nachtluce/3710-Project/Final Handin/Documentation/Implementation Documents/CPU Design.xls

Modules: | ALU |  |  |  |  |  | Mux(ALU Input) |  |  |  |  |  | VGA Start Address Register
ALU | Input |  |  | Output |  |  | Input |  |  | Output |  |  | Input |  |  | Output
Registers | Out(ALU Input) | >> | A | S | >> | In(Registers), In(ProgramCounter) | CPU | >> | InA | Out | >> | A(ALU) | Clock | >> | Clock | Out | >> | VGA
MemoryController | B(Registers) | >> | B | CLFZN | >> | In(PSR Register) | A(Registers) | >> | InB |  |  |  | CPU | >> | Reset
Mux | CPU | >> | OpCode |  |  |  | DataOut | >> | InC |  |  |  | CPU | >> | WriteEnable
CPUController | CPU | >> | OpExt |  |  |  | PC-Out | >> | InD |  |  |  | S | >> | In
PSR | PSR[4] | >> | Carry |  |  |  | CPU | >> | Select
ProgramCounter |  |  |  |  |  |  |  |  |  |  |  |  | VGA Row Length Register
InstructionRegister | Registers |  |  |  |  |  | Mux(MEM Addr) |  |  |  |  |  | Input |  |  | Output
 | Input |  |  | Output |  |  | Input |  |  | Output |  |  | Clock | >> | Clock | Out | >> | VGA
 | Clock | >> | Clock | A | >> | InA(ALU Input) | B(Registers) | >> | InA | Out | >> | Addr(MemoryController) | CPU | >> | Reset
 | Reset | >> | Reset | B | >> | A(ALU), InA(MEM Input) | PC | >> | InB |  |  |  | CPU | >> | WriteEnable
 | CPU | >> | WriteEnable |  |  |  | XX | >> | InC |  |  |  | S | >> | In
 | CPU | >> | SelectIn |  |  |  | XX | >> | InD
 | CPU | >> | SelectA |  |  |  | CPU | >> | Select
 | CPU | >> | SelectB
 | S(ALU) | >> | In |  |  |  | MemoryController
 |  |  |  |  |  |  | Input |  |  | Output
 | CPU Controller |  |  |  |  |  | Clock | >> | Clock | DataOut | >> | In(IR), InC(ALU Input)
 | Input |  |  | Output |  |  | CPU | >> | RW
 | Clock | >> | Clock | OpCode | >> | OpCode(ALU) | Out(MEM) | >> | Addr
 | Reset | >> | Reset | OpExt | >> | OpExt(ALU) | S(ALU) | >> | DataIn
 | INS | >> | INS | RegWrite | >> | WriteEnable(Registers)
 | PSR | >> | PSR | RegIn | >> | SelectIn(Registers) | Program Counter
 | GamePad | >> | GamePad | RegA | >> | SelectA(Registers) | Input |  |  | Output
 | SerialRead | >> | SerialControl | RegB | >> | SelectB(Registers) | Clock | >> | Clock | PC | >> | InB(MEM)
 | SerialValid | >> | SerialControl | Immediate | >> | InA(ALU Input) | CPU | >> | Reset
 |  |  |  | SelALU | >> | Select(ALU Input) | CPU | >> | WriteEnable
 |  |  |  | SelMEM | >> | Select(MEM Addr) | CPU | >> | Increment
 |  |  |  | MemRW | >> | RW(MemoryController) | S(ALU) | >> | In
 |  |  |  | PCWrite | >> | WriteEnable(Program Counter) | Immediate | >> | ImmIn
 |  |  |  | PCIncrement | >> | Increment(Program Counter)
 |  |  |  | PCReset | >> | Reset(Program Counter) | Instruction Register
 |  |  |  | IRReset | >> | Reset(Instruction Register) | Input |  |  | Output
 |  |  |  | IRWrite | >> | WriteEnable(Instruction Register) | Clock | >> | Clock | INS | >> | INS(CPU)
 |  |  |  | PSRReset | >> | Reset(Processor Status Register) | CPU | >> | Reset
 |  |  |  | PSREnable | >> | Enable(PSR) | CPU | >> | WriteEnable
 |  |  |  | VGAS_E | >> | Enable(VGAS-Reg) | DataOut | >> | In
 |  |  |  | VGAS_R | >> | Reset(VGAS-Reg
 |  |  |  | VGAR_E | >> | Enable(VGAR-Reg) | Processor Status Register
 |  |  |  | VGAR_R | >> | Reset(VGAR-Reg) | Input |  |  | Output
 |  |  |  | SerialWrite | >> | SerialControl | Clock | >> | Clock | PSR | >> | PSR(CPU), Carry(ALU)
 |  |  |  |  |  |  | CPU | >> | Reset
 |  |  |  |  |  |  | CLFZN(ALU) | >> | In
 |  |  |  |  |  |  | CPU | >> | Enable
