nachtluce/3710-Project/Final Handin/Project Code/Modules/VGA Controller/vgaBitGen.v

`timescale 1ns / 1ps
//////////////////////////////////////////////////////////////////////////////////
// Company: 
// Engineer: 
// 
// Create Date:    23:13:00 11/05/2011 
// Design Name: 
// Module Name:    vgaBitGen 
// Project Name: 
// Target Devices: 
// Tool versions: 
// Description: 
//
// Dependencies: 
//
// Revision: 
// Revision 0.01 - File Created
// Additional Comments: 
//
//////////////////////////////////////////////////////////////////////////////////
module vgaBitGen(
    input [8:0] picNum,
    input [4:0] xSubCount,
    input [4:0] ySubCount,
    input clk,
	 input act,
    output reg R,
    output reg B,
    output reg G
    );
	//memory
	
//ok this starts are the picNum we have 16 columns per superpixel
// and those 16 columns are within 6 addresses
//we start at 0x00 for our picture values
//pic1 is 0x00 to 0x5F
//pic2 is 0x60 to 0xBF
//pic3 is 0xC0 to 0x11F
//pic4 is 0x120 to 0x17F
//...
	reg[3:0] xWord;
	reg[10:0] yWord;
	wire [8:0] MemData;
	reg [11:0] fetchAddress;//this is the location to fetch in vga memory

	VGA_memory mem(~clk, 1'b0, fetchAddress, 9'b0_0000_0000, MemData);
	//on the posEdge of the clock what ever is on the fetch address, the memory on that location the memory will return on MemData or the value
	//of memData will be valid at the same clock
	
	
	

//always @(*)
//begin
//	if(xSubCount < 5 || xSubCount == 31)//first 6 pixels
//		 xWord = 0;
//	else if(xSubCount > 4 && xSubCount < 11)//6 to 12
//		 xWord = 1;
//	else if(xSubCount > 10 && xSubCount < 17)//12 to 18
//		 xWord = 2;
//	else if(xSubCount > 16 && xSubCount < 23)//18 to 24
//		 xWord = 3;//this section might still be off
//	else if(xSubCount > 22 && xSubCount < 29)//24 to 30
//		 xWord = 4;
//	else if(xSubCount > 28  && xSubCount < 31)//30 to 32
//		 xWord = 5;
//end
always @(*)
begin
	if(xSubCount < 6 || xSubCount == 31)//first 6 pixels
		 xWord = 0;
	else if(xSubCount > 5 && xSubCount < 12)//6 to 12
		 xWord = 1;
	else if(xSubCount > 11 && xSubCount < 18)//12 to 18
		 xWord = 2;
	else if(xSubCount > 12 && xSubCount < 24)//18 to 24
		 xWord = 3;//this section might still be off
	else if(xSubCount > 23 && xSubCount < 30)//24 to 30
		 xWord = 4;
	else if(xSubCount > 29  && xSubCount < 32)//30 to 32
		 xWord = 5;
end


//always @(*)
//	begin
//			if(ySubCount < 2)//row 0 of 16
//				 fetchAddress = xWord + (95 * picNum);
//			 else if(ySubCount > 1 && ySubCount < 4) //row 1
//				 fetchAddress = xWord + 6+ (95 * picNum);//
//			 else if(ySubCount > 3 && ySubCount < 6) //row 2
//				 fetchAddress = xWord + 12+ (95 * picNum);//
//			 else if(ySubCount > 5 && ySubCount < 8) //row 3
//				 fetchAddress = xWord + 18+ (95 * picNum);//
//			 else if(ySubCount > 7 && ySubCount < 10) //row 4
//				 fetchAddress = xWord + 24+ (95 * picNum);//
//			 else if(ySubCount > 9 && ySubCount < 12) //row 5
//				 fetchAddress = xWord + 30+ (95 * picNum);//
//			 else if(ySubCount > 11 && ySubCount < 14) //row 6
//				 fetchAddress = xWord + 36+ (95 * picNum);//
//			 else if(ySubCount > 13 && ySubCount < 16) //row 7
//				 fetchAddress = xWord + 42+ (95 * picNum);//
//			 else if(ySubCount > 15 && ySubCount < 18) //row 8
//				 fetchAddress = xWord + 48+ (95 * picNum);//
//			 else if(ySubCount > 17 && ySubCount < 20) //row 9
//				 fetchAddress = xWord + 54+ (95 * picNum);//
//			 else if(ySubCount > 19 && ySubCount < 22) //row 10
//				 fetchAddress = xWord + 60+ (95 * picNum);//
//			 else if(ySubCount > 21 && ySubCount < 24) //row 11
//				 fetchAddress = xWord + 66+ (95 * picNum);//
//			 else if(ySubCount > 23 && ySubCount < 26) //row 12
//				 fetchAddress = xWord + 72+ (95 * picNum);//
//			 else if(ySubCount > 25 && ySubCount < 28) //row 13
//				 fetchAddress = xWord + 78+ (95 * picNum);//
//			 else if(ySubCount > 27 && ySubCount < 30) //row 14
//				 fetchAddress = xWord + 84+ (95 * picNum);//
//			 else if(ySubCount > 29 && ySubCount < 32) //row 14
//				 fetchAddress = xWord + 90+ (95 * picNum);//
//			 else
//				 fetchAddress = 10'b0000_0000_00;
//			
//		 //end
////	
////		if(ySubCount < 2)
////			yWord = 0;
////		else if(ySubCount > 1 && ySubCount < 4)
////			yWord = 1;
////		else if(ySubCount > 3 && ySubCount < 6)
////			yWord = 2;
////		else if(ySubCount > 5 && ySubCount < 8)
////			yWord = 3;
////		else if(ySubCount > 7 && ySubCount < 10)
////			yWord = 4;
////		else if(ySubCount > 9 && ySubCount < 12)
////			yWord = 5;
////		else if(ySubCount > 11 && ySubCount < 14)
////			yWord = 6;
////		else if(ySubCount > 13 && ySubCount < 16)
////			yWord = 7;
////		else if(ySubCount > 15 && ySubCount < 18)
////			yWord = 8;
////		else if(ySubCount > 17 && ySubCount < 20)
////			yWord = 9;
////		else if(ySubCount > 19 && ySubCount < 22)
////			yWord = 10;
////		else if(ySubCount > 21 && ySubCount < 24)
////			yWord = 11;
////		else if(ySubCount > 23 && ySubCount < 26)
////			yWord = 12;
////		else if(ySubCount > 25 && ySubCount < 28)
////			yWord = 13;
////		else if(ySubCount > 27 && ySubCount < 30)
////			yWord = 14;
////		else if(ySubCount > 29 && ySubCount < 32)
////			yWord = 15;
////		else
////			yWord = 0;
//		
//	
//	end

//always @(*)
//begin												
//	fetchAddress = ((picNum * 95) +(yWord * 6)+(xWord ));
//end
//
always @(*)//this use to be posegde clk
begin
		//we need a multiplier to advance the image address based on 
		//fetchAddress = (picNum * 95) +(xWord + yWord);
		//example 0 * 95 = 0 + (0 +0); = 0
		//example 2  1 * 95 +
		 if(picNum == 0)//Dude Right
		 begin
		
			
			 if(ySubCount < 2)//row 0 of 16
				 fetchAddress = xWord + 0;
			 else if(ySubCount > 1 && ySubCount < 4) //row 1
				 fetchAddress = xWord + 6;//
			 else if(ySubCount > 3 && ySubCount < 6) //row 2
				 fetchAddress = xWord + 12;//
			 else if(ySubCount > 5 && ySubCount < 8) //row 3
				 fetchAddress = xWord + 18;//
			 else if(ySubCount > 7 && ySubCount < 10) //row 4
				 fetchAddress = xWord + 24;//
			 else if(ySubCount > 9 && ySubCount < 12) //row 5
				 fetchAddress = xWord + 30;//
			 else if(ySubCount > 11 && ySubCount < 14) //row 6
				 fetchAddress = xWord + 36;//
			 else if(ySubCount > 13 && ySubCount < 16) //row 7
				 fetchAddress = xWord + 42;//
			 else if(ySubCount > 15 && ySubCount < 18) //row 8
				 fetchAddress = xWord + 48;//
			 else if(ySubCount > 17 && ySubCount < 20) //row 9
				 fetchAddress = xWord + 54;//
			 else if(ySubCount > 19 && ySubCount < 22) //row 10
				 fetchAddress = xWord + 60;//
			 else if(ySubCount > 21 && ySubCount < 24) //row 11
				 fetchAddress = xWord + 66;//
			 else if(ySubCount > 23 && ySubCount < 26) //row 12
				 fetchAddress = xWord + 72;//
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
//R = MemData[8];
//			G = MemData[7];
//			B = MemData[6];

		end
		else if(xSubCount < 18 && xSubCount > 15 && act)
		begin
	
	//		{R,B,G} = 3'b110;//Set Red for all of the pixels
			{R,B,G} = MemData[2:0];//set the RGB		pixel 9
//R = MemData[8];
//			G = MemData[7];
//			B = MemData[6];

		end
		else if(xSubCount < 20 && xSubCount > 17 && act)
		begin
		
//			{R,B,G} = 3'b110;//Set Red for all of the pixels
			{R,B,G} = MemData[8:6];//set the RGB		pixel 10
//R = MemData[8];
//			G = MemData[7];
//			B = MemData[6];

		end
		else if(xSubCount < 22 && xSubCount > 19 && act)
		begin

//			{R,B,G} = 3'b110;//Set Red for all of the pixels
			{R,B,G} = MemData[5:3];//set the RGB		pixel 11
		end
		else if(xSubCount < 24 && xSubCount > 21 && act)
		begin
		
	//		{R,B,G} = 3'b110;//Set Red for all of the pixels
			{R,B,G} = MemData[2:0];//set the RGB		pixel 12
		end
		else if(xSubCount < 26 && xSubCount > 23 && act)
		begin

//			{R,B,G} = 3'b110;//Set Red for all of the pixels		
		{R,B,G} = MemData[8:6];//set the RGB		pixel 13
		end
		else if(xSubCount < 28 && xSubCount > 25 && act)
		begin

//			{R,B,G} = 3'b110;//Set Red for all of the pixels	
	{R,B,G} = MemData[5:3];//set the RGB		pixel 14
		end
		else if(xSubCount < 30 && xSubCount > 27 && act)
		begin

//			{R,B,G} = 3'b110;//Set Red for all of the pixels	
	{R,B,G} = MemData[2:0];//set the RGB		pixel 15
		end
		else if(xSubCount < 32 && xSubCount > 29 && act)
		begin
	
	//		{R,B,G} = 3'b110;//Set Red for all of the pixels
			{R,B,G} = MemData[8:6];//set the RGB		pixel 16
		end//000000000, we want the first 2 locations set
		//100001010;0x10A
		else
			{R,B,G} = 0;
		
		
end


endmodule
