nachtluce/3710-Project/Final Handin/Project Code/Modules/VGA Controller/VGASuperPixConverter.v

`timescale 1ns / 1ps
//////////////////////////////////////////////////////////////////////////////////
// Company: 
// Engineer: 
// 
// Create Date:    12:19:10 11/01/2011 
// Design Name: 
// Module Name:    VGASuperPixConverter 
// Project Name: 
// Target Devices: 
// Tool versions: 
// Description: This module is to convert the col and row into a 
//
// Dependencies: 
//
// Revision: 
// Revision 0.01 - File Created
// Additional Comments: 
//
//////////////////////////////////////////////////////////////////////////////////
module VGASuperPixConverter(
    input [9:0] col,
    input [8:0] row,
    output reg [4:0] xSupPix,
    output reg [3:0] ySupPix,
	 output reg [4:0] xSubCount,
	 output reg [4:0] ySubCount	 
    );
always @(*)
begin 

		xSupPix = 0;
		 ySupPix = 0;
	if(col < 32)// && act)
	begin	
		xSupPix = 0; 
		 xSubCount = col;
	end
	else if( col >31 && col < 64)// && act)//pixels 32 - 63
	begin
		 xSupPix = 1;
		 xSubCount = col - 32;
	end
	else if( col >63 && col < 96)//&& act)//pixels 32 - 63
	begin
		 xSupPix = 2;
		 xSubCount = col - 64;
	end
	else if( col >95 && col < 128)// && act)//pixels 32 - 63
	begin
		 xSupPix = 3;
		 xSubCount = col - 96;
	end
	else if( col >127 && col < 160)// && act)//pixels 32 - 63
	begin
		 xSupPix = 4;
		 xSubCount = col - 128;
	end
	else if( col >159 && col < 192)// && act)//pixels 32 - 63
	begin
		 xSupPix = 5;
		 xSubCount = col - 160;
	end
	else if( col >191 && col < 224)// && act)//pixels 32 - 63
	begin	
		 xSupPix = 6;
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
	end
	else if( row > 415 && row < 448)// && act)
	begin
		 ySupPix = 13;
		 ySubCount = row - 416;
	end
	else if( row > 447 && row < 480)// && act)
	begin
		 ySupPix = 14;
		 ySubCount = row - 448;
	end
	else
	begin
		 ySupPix = 5'bxxxxx;
		 ySubCount = 5'bxxxxx;
	end
	 
end
endmodule
