nachtluce/3710-Project/Final Handin/Project Code/Modules/CPU/Processor_Status_Register.v

`timescale 1ns / 1ps
//////////////////////////////////////////////////////////////////////////////////
// Company: 
// Engineer:	Levi Balling, Robert Christensen, James Lewis
// 
// Create Date:    15:07:38 09/19/2011 
// Design Name: 
// Module Name:    Processor_Status_Register 
// Project Name: 
// Target Devices: 
// Tool versions: 
// Description: 
//
// Dependencies: 
//
// Revision: 
// Revision 0.01 - File Created
// Additional Comments: 
//
//////////////////////////////////////////////////////////////////////////////////
module Processor_Status_Register(
	 input clock,
	 input reset,
	 input enable,
    input [4:0] CZLFM_in,
    output reg[4:0] CZLFN_out 
    );

always@(posedge clock, negedge reset)
begin
	if (~reset)
		CZLFN_out <= 0;
	else	
	if (enable)
		CZLFN_out <= CZLFM_in;
		
end

endmodule
