nachtluce/3710-Project/Final Handin/Project Code/Test Benches/ALU_simulation/ALUmod_synthesis.v

////////////////////////////////////////////////////////////////////////////////
// Copyright (c) 1995-2010 Xilinx, Inc.  All rights reserved.
////////////////////////////////////////////////////////////////////////////////
//   ____  ____
//  /   /\/   /
// /___/  \  /    Vendor: Xilinx
// \   \   \/     Version: M.53d
//  \   \         Application: netgen
//  /   /         Filename: ALUmod_synthesis.v
// /___/   /\     Timestamp: Thu Sep 22 15:55:03 2011
// \   \  /  \ 
//  \___\/\___\
//             
// Command	: -intstyle ise -insert_glbl true -w -dir netgen/synthesis -ofmt verilog -sim ALUmod.ngc ALUmod_synthesis.v 
// Device	: xc3s500e-5-vq100
// Input file	: ALUmod.ngc
// Output file	: C:\Users\robertc\Documents\school\CS3710\ALU\netgen\synthesis\ALUmod_synthesis.v
// # of Modules	: 1
// Design Name	: ALUmod
// Xilinx        : C:\Xilinx\12.1\ISE_DS\ISE
//             
// Purpose:    
//     This verilog netlist is a verification model and uses simulation 
//     primitives which may not represent the true implementation of the 
//     device, however the netlist is functionally correct and should not 
//     be modified. This file cannot be synthesized and should only be used 
//     with supported simulation tools.
//             
// Reference:  
//     Command Line Tools User Guide, Chapter 23 and Synthesis and Simulation Design Guide, Chapter 6
//             
////////////////////////////////////////////////////////////////////////////////

`timescale 1 ns/1 ps

module ALUmodSynth (
  carry, S, CLFZN, opext, A, B, opcode
);
  input carry;
  output [15 : 0] S;
  output [4 : 0] CLFZN;
  input [3 : 0] opext;
  input [15 : 0] A;
  input [15 : 0] B;
  input [3 : 0] opcode;
  wire A_0_IBUF_32;
  wire A_10_IBUF_33;
  wire A_11_IBUF_34;
  wire A_12_IBUF_35;
  wire A_13_IBUF_36;
  wire A_14_IBUF_37;
  wire A_15_IBUF_38;
  wire A_1_IBUF_39;
  wire A_2_IBUF_40;
  wire A_3_IBUF_41;
  wire A_4_IBUF_42;
  wire A_5_IBUF_43;
  wire A_6_IBUF_44;
  wire A_7_IBUF_45;
  wire A_8_IBUF_46;
  wire A_9_IBUF_47;
  wire B_0_IBUF_64;
  wire B_10_IBUF_65;
  wire B_11_IBUF_66;
  wire B_12_IBUF_67;
  wire B_13_IBUF_68;
  wire B_14_IBUF_69;
  wire B_15_IBUF_70;
  wire B_1_IBUF_71;
  wire B_2_IBUF_72;
  wire B_3_IBUF_73;
  wire B_4_IBUF_74;
  wire B_5_IBUF_75;
  wire B_6_IBUF_76;
  wire B_7_IBUF_77;
  wire B_8_IBUF_78;
  wire B_9_IBUF_79;
  wire CLFZN_0_OBUF_85;
  wire CLFZN_0_mux000018_86;
  wire CLFZN_1_OBUF_87;
  wire CLFZN_2_OBUF_88;
  wire CLFZN_2_mux000112_89;
  wire CLFZN_2_mux0001124_90;
  wire CLFZN_2_mux0001153_91;
  wire CLFZN_2_mux0001172_92;
  wire CLFZN_2_mux000121_93;
  wire CLFZN_2_mux00015_94;
  wire CLFZN_2_mux000155_95;
  wire CLFZN_2_mux000170_96;
  wire CLFZN_3_OBUF_97;
  wire CLFZN_4_OBUF_98;
  wire CLFZN_4_cmp_eq0001;
  wire CLFZN_4_cmp_eq0002;
  wire CLFZN_4_cmp_eq00031;
  wire CLFZN_4_cmp_eq0004;
  wire CLFZN_4_cmp_eq0005;
  wire CLFZN_4_cmp_eq0008;
  wire CLFZN_4_cmp_eq0009;
  wire CLFZN_4_cmp_eq0010;
  wire CLFZN_4_cmp_eq0013;
  wire CLFZN_4_cmp_eq00131_108;
  wire CLFZN_4_cmp_eq0016;
  wire Madd_AUX_5_index0000;
  wire \Madd__AUX_9_cy<10>_rt_144 ;
  wire \Madd__AUX_9_cy<11>_rt_146 ;
  wire \Madd__AUX_9_cy<12>_rt_148 ;
  wire \Madd__AUX_9_cy<13>_rt_150 ;
  wire \Madd__AUX_9_cy<14>_rt_152 ;
  wire \Madd__AUX_9_cy<15>_rt_154 ;
  wire \Madd__AUX_9_cy<1>_rt_156 ;
  wire \Madd__AUX_9_cy<2>_rt_158 ;
  wire \Madd__AUX_9_cy<3>_rt_160 ;
  wire \Madd__AUX_9_cy<4>_rt_162 ;
  wire \Madd__AUX_9_cy<5>_rt_164 ;
  wire \Madd__AUX_9_cy<6>_rt_166 ;
  wire \Madd__AUX_9_cy<7>_rt_168 ;
  wire \Madd__AUX_9_cy<8>_rt_170 ;
  wire \Madd__AUX_9_cy<9>_rt_172 ;
  wire \Madd__AUX_9_xor<16>_rt_174 ;
  wire N0;
  wire N01;
  wire N1;
  wire N10;
  wire N11;
  wire N18;
  wire N2;
  wire N3;
  wire N36;
  wire N38;
  wire N39;
  wire N411;
  wire N42;
  wire N43;
  wire N44;
  wire N47;
  wire N5;
  wire N55;
  wire N57;
  wire N59;
  wire N61;
  wire N63;
  wire N65;
  wire N67;
  wire N69;
  wire N7;
  wire N71;
  wire N73;
  wire N75;
  wire N77;
  wire N8;
  wire N81;
  wire N89;
  wire N9;
  wire N91;
  wire N93;
  wire N94;
  wire \S<0>136_324 ;
  wire \S<0>17_325 ;
  wire \S<0>182_326 ;
  wire \S<0>217_327 ;
  wire \S<0>232_328 ;
  wire \S<0>258_329 ;
  wire \S<0>30_330 ;
  wire \S<0>4_331 ;
  wire \S<0>43_332 ;
  wire \S<0>67_333 ;
  wire \S<0>76_334 ;
  wire \S<0>89_335 ;
  wire \S<10>11 ;
  wire \S<10>1116_338 ;
  wire \S<10>144_339 ;
  wire \S<10>21_340 ;
  wire \S<10>4_341 ;
  wire \S<10>40_342 ;
  wire \S<10>49_343 ;
  wire \S<10>7_344 ;
  wire \S<11>11_346 ;
  wire \S<11>21_347 ;
  wire \S<11>4_348 ;
  wire \S<11>40_349 ;
  wire \S<11>49_350 ;
  wire \S<11>7_351 ;
  wire \S<12>11_353 ;
  wire \S<12>21_354 ;
  wire \S<12>4_355 ;
  wire \S<12>40_356 ;
  wire \S<12>49_357 ;
  wire \S<12>7_358 ;
  wire \S<13>11_360 ;
  wire \S<13>21_361 ;
  wire \S<13>4_362 ;
  wire \S<13>40_363 ;
  wire \S<13>49_364 ;
  wire \S<13>7_365 ;
  wire \S<14>13_367 ;
  wire \S<14>32_368 ;
  wire \S<14>53_369 ;
  wire \S<14>6_370 ;
  wire \S<15>110_372 ;
  wire \S<15>125_373 ;
  wire \S<15>45_374 ;
  wire \S<15>61_375 ;
  wire \S<15>79_376 ;
  wire \S<15>95_377 ;
  wire \S<1>11_379 ;
  wire \S<1>18_380 ;
  wire \S<1>22_381 ;
  wire \S<1>4_382 ;
  wire \S<1>45_383 ;
  wire \S<1>54_384 ;
  wire \S<2>11_386 ;
  wire \S<2>18_387 ;
  wire \S<2>22_388 ;
  wire \S<2>4_389 ;
  wire \S<2>45_390 ;
  wire \S<2>54_391 ;
  wire \S<3>11_393 ;
  wire \S<3>18_394 ;
  wire \S<3>22_395 ;
  wire \S<3>4_396 ;
  wire \S<3>45_397 ;
  wire \S<3>54_398 ;
  wire \S<4>11_400 ;
  wire \S<4>18_401 ;
  wire \S<4>22_402 ;
  wire \S<4>4_403 ;
  wire \S<4>45_404 ;
  wire \S<4>54_405 ;
  wire \S<5>11_407 ;
  wire \S<5>18_408 ;
  wire \S<5>4_409 ;
  wire \S<5>45_410 ;
  wire \S<5>54_411 ;
  wire \S<5>73 ;
  wire \S<6>11_414 ;
  wire \S<6>18_415 ;
  wire \S<6>4_416 ;
  wire \S<6>45_417 ;
  wire \S<6>54_418 ;
  wire \S<6>73 ;
  wire \S<7>11_421 ;
  wire \S<7>21_422 ;
  wire \S<7>40_423 ;
  wire \S<7>49_424 ;
  wire \S<7>61_425 ;
  wire \S<8>11_427 ;
  wire \S<8>21_428 ;
  wire \S<8>4_429 ;
  wire \S<8>40_430 ;
  wire \S<8>49_431 ;
  wire \S<8>7_432 ;
  wire \S<9>11_434 ;
  wire \S<9>21_435 ;
  wire \S<9>4_436 ;
  wire \S<9>40_437 ;
  wire \S<9>49_438 ;
  wire \S<9>7_439 ;
  wire S_0_OBUF_440;
  wire S_10_OBUF_441;
  wire S_11_OBUF_442;
  wire S_12_OBUF_443;
  wire S_13_OBUF_444;
  wire S_14_OBUF_445;
  wire S_15_OBUF_446;
  wire S_1_OBUF_447;
  wire S_2_OBUF_448;
  wire S_3_OBUF_449;
  wire S_4_OBUF_450;
  wire S_5_OBUF_451;
  wire S_6_OBUF_452;
  wire S_7_OBUF_453;
  wire S_8_OBUF_454;
  wire S_9_OBUF_455;
  wire carry_IBUF_490;
  wire opcode_0_IBUF_495;
  wire opcode_1_IBUF_496;
  wire opcode_2_IBUF_497;
  wire opcode_3_IBUF_498;
  wire opext_0_IBUF_503;
  wire opext_1_IBUF_504;
  wire opext_2_IBUF_505;
  wire opext_3_IBUF_506;
  wire [15 : 0] AUX_5_addsub0000;
  wire [14 : 0] Madd_AUX_5_addsub0000_cy;
  wire [15 : 0] Madd_AUX_5_addsub0000_lut;
  wire [15 : 0] Madd__AUX_9_cy;
  wire [0 : 0] Madd__AUX_9_lut;
  wire [7 : 0] Mcompar_CLFZN_cmp_eq0000_cy;
  wire [7 : 0] Mcompar_CLFZN_cmp_eq0000_lut;
  wire [15 : 0] Mcompar_CLFZN_cmp_gt0000_cy;
  wire [15 : 0] Mcompar_CLFZN_cmp_gt0000_lut;
  wire [15 : 0] Mcompar_CLFZN_cmp_gt0001_cy;
  wire [15 : 0] Mcompar_CLFZN_cmp_gt0001_lut;
  wire [14 : 0] Msub__old_S_10_cy;
  wire [15 : 0] Msub__old_S_10_lut;
  wire [16 : 0] _AUX_9;
  wire [15 : 0] _old_S_10;
  GND   XST_GND (
    .G(N0)
  );
  VCC   XST_VCC (
    .P(N1)
  );
  LUT2 #(
    .INIT ( 4'h6 ))
  \Madd_AUX_5_addsub0000_lut<0>  (
    .I0(A_0_IBUF_32),
    .I1(B_0_IBUF_64),
    .O(Madd_AUX_5_addsub0000_lut[0])
  );
  MUXCY   \Madd_AUX_5_addsub0000_cy<0>  (
    .CI(N0),
    .DI(A_0_IBUF_32),
    .S(Madd_AUX_5_addsub0000_lut[0]),
    .O(Madd_AUX_5_addsub0000_cy[0])
  );
  XORCY   \Madd_AUX_5_addsub0000_xor<0>  (
    .CI(N0),
    .LI(Madd_AUX_5_addsub0000_lut[0]),
    .O(AUX_5_addsub0000[0])
  );
  LUT2 #(
    .INIT ( 4'h6 ))
  \Madd_AUX_5_addsub0000_lut<1>  (
    .I0(A_1_IBUF_39),
    .I1(B_1_IBUF_71),
    .O(Madd_AUX_5_addsub0000_lut[1])
  );
  MUXCY   \Madd_AUX_5_addsub0000_cy<1>  (
    .CI(Madd_AUX_5_addsub0000_cy[0]),
    .DI(A_1_IBUF_39),
    .S(Madd_AUX_5_addsub0000_lut[1]),
    .O(Madd_AUX_5_addsub0000_cy[1])
  );
  XORCY   \Madd_AUX_5_addsub0000_xor<1>  (
    .CI(Madd_AUX_5_addsub0000_cy[0]),
    .LI(Madd_AUX_5_addsub0000_lut[1]),
    .O(AUX_5_addsub0000[1])
  );
  LUT2 #(
    .INIT ( 4'h6 ))
  \Madd_AUX_5_addsub0000_lut<2>  (
    .I0(A_2_IBUF_40),
    .I1(B_2_IBUF_72),
    .O(Madd_AUX_5_addsub0000_lut[2])
  );
  MUXCY   \Madd_AUX_5_addsub0000_cy<2>  (
    .CI(Madd_AUX_5_addsub0000_cy[1]),
    .DI(A_2_IBUF_40),
    .S(Madd_AUX_5_addsub0000_lut[2]),
    .O(Madd_AUX_5_addsub0000_cy[2])
  );
  XORCY   \Madd_AUX_5_addsub0000_xor<2>  (
    .CI(Madd_AUX_5_addsub0000_cy[1]),
    .LI(Madd_AUX_5_addsub0000_lut[2]),
    .O(AUX_5_addsub0000[2])
  );
  LUT2 #(
    .INIT ( 4'h6 ))
  \Madd_AUX_5_addsub0000_lut<3>  (
    .I0(A_3_IBUF_41),
    .I1(B_3_IBUF_73),
    .O(Madd_AUX_5_addsub0000_lut[3])
  );
  MUXCY   \Madd_AUX_5_addsub0000_cy<3>  (
    .CI(Madd_AUX_5_addsub0000_cy[2]),
    .DI(A_3_IBUF_41),
    .S(Madd_AUX_5_addsub0000_lut[3]),
    .O(Madd_AUX_5_addsub0000_cy[3])
  );
  XORCY   \Madd_AUX_5_addsub0000_xor<3>  (
    .CI(Madd_AUX_5_addsub0000_cy[2]),
    .LI(Madd_AUX_5_addsub0000_lut[3]),
    .O(AUX_5_addsub0000[3])
  );
  LUT2 #(
    .INIT ( 4'h6 ))
  \Madd_AUX_5_addsub0000_lut<4>  (
    .I0(A_4_IBUF_42),
    .I1(B_4_IBUF_74),
    .O(Madd_AUX_5_addsub0000_lut[4])
  );
  MUXCY   \Madd_AUX_5_addsub0000_cy<4>  (
    .CI(Madd_AUX_5_addsub0000_cy[3]),
    .DI(A_4_IBUF_42),
    .S(Madd_AUX_5_addsub0000_lut[4]),
    .O(Madd_AUX_5_addsub0000_cy[4])
  );
  XORCY   \Madd_AUX_5_addsub0000_xor<4>  (
    .CI(Madd_AUX_5_addsub0000_cy[3]),
    .LI(Madd_AUX_5_addsub0000_lut[4]),
    .O(AUX_5_addsub0000[4])
  );
  LUT2 #(
    .INIT ( 4'h6 ))
  \Madd_AUX_5_addsub0000_lut<5>  (
    .I0(A_5_IBUF_43),
    .I1(B_5_IBUF_75),
    .O(Madd_AUX_5_addsub0000_lut[5])
  );
  MUXCY   \Madd_AUX_5_addsub0000_cy<5>  (
    .CI(Madd_AUX_5_addsub0000_cy[4]),
    .DI(A_5_IBUF_43),
    .S(Madd_AUX_5_addsub0000_lut[5]),
    .O(Madd_AUX_5_addsub0000_cy[5])
  );
  XORCY   \Madd_AUX_5_addsub0000_xor<5>  (
    .CI(Madd_AUX_5_addsub0000_cy[4]),
    .LI(Madd_AUX_5_addsub0000_lut[5]),
    .O(AUX_5_addsub0000[5])
  );
  LUT2 #(
    .INIT ( 4'h6 ))
  \Madd_AUX_5_addsub0000_lut<6>  (
    .I0(A_6_IBUF_44),
    .I1(B_6_IBUF_76),
    .O(Madd_AUX_5_addsub0000_lut[6])
  );
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
    .I0(N10),
    .I1(opext_3_IBUF_506),
    .I2(opext_1_IBUF_504),
    .I3(B_14_IBUF_69),
    .O(N57)
  );
  LUT4 #(
    .INIT ( 16'h0400 ))
  CLFZN_2_mux000170_SW0 (
    .I0(opext_3_IBUF_506),
    .I1(N36),
    .I2(B_15_IBUF_70),
    .I3(N8),
    .O(N75)
  );
  LUT4 #(
    .INIT ( 16'hFBBB ))
  \S<10>1116_SW1  (
    .I0(N67),
    .I1(\S<10>144_339 ),
    .I2(N39),
    .I3(opext_1_IBUF_504),
    .O(N89)
  );
  LUT4 #(
    .INIT ( 16'h2E2A ))
  \S<10>1116_SW0  (
    .I0(opext_0_IBUF_503),
    .I1(opext_2_IBUF_505),
    .I2(opext_3_IBUF_506),
    .I3(opext_1_IBUF_504),
    .O(N91)
  );
  LUT3 #(
    .INIT ( 8'h13 ))
  \S<10>1116  (
    .I0(N8),
    .I1(N89),
    .I2(N91),
    .O(\S<10>1116_338 )
  );
  MUXF5   \S<10>144  (
    .I0(N93),
    .I1(N94),
    .S(opext_1_IBUF_504),
    .O(\S<10>144_339 )
  );
  LUT3 #(
    .INIT ( 8'h7F ))
  \S<10>144_F  (
    .I0(N9),
    .I1(opext_0_IBUF_503),
    .I2(opext_2_IBUF_505),
    .O(N93)
  );
  LUT4 #(
    .INIT ( 16'hFF31 ))
  \S<10>144_G  (
    .I0(N44),
    .I1(N9),
    .I2(opext_2_IBUF_505),
    .I3(opext_0_IBUF_503),
    .O(N94)
  );
  LUT4 #(
    .INIT ( 16'h0800 ))
  CLFZN_4_cmp_eq00131 (
    .I0(opext_2_IBUF_505),
    .I1(opext_1_IBUF_504),
    .I2(opext_0_IBUF_503),
    .I3(N8),
    .O(CLFZN_4_cmp_eq00131_108)
  );
  MUXF5   CLFZN_4_cmp_eq0013_f5 (
    .I0(N0),
    .I1(CLFZN_4_cmp_eq00131_108),
    .S(opext_3_IBUF_506),
    .O(CLFZN_4_cmp_eq0013)
  );
  LUT4 #(
    .INIT ( 16'h0400 ))
  CLFZN_4_cmp_eq000311 (
    .I0(opcode_2_IBUF_497),
    .I1(opcode_1_IBUF_496),
    .I2(opcode_0_IBUF_495),
    .I3(opcode_3_IBUF_498),
    .O(CLFZN_4_cmp_eq00031)
  );
  MUXF5   CLFZN_4_cmp_eq00031_f5 (
    .I0(CLFZN_4_cmp_eq00031),
    .I1(N0),
    .S(opext_3_IBUF_506),
    .O(N9)
  );
  LUT4 #(
    .INIT ( 16'hFFEA ))
  \S<6>731  (
    .I0(\S<6>4_416 ),
    .I1(A_5_IBUF_43),
    .I2(N3),
    .I3(\S<6>18_415 ),
    .O(\S<6>73 )
  );
  MUXF5   \S<6>73_f5  (
    .I0(\S<6>73 ),
    .I1(N1),
    .S(\S<6>54_418 ),
    .O(S_6_OBUF_452)
  );
  LUT4 #(
    .INIT ( 16'hFFEA ))
  \S<5>731  (
    .I0(\S<5>4_409 ),
    .I1(A_4_IBUF_42),
    .I2(N3),
    .I3(\S<5>18_408 ),
    .O(\S<5>73 )
  );
  MUXF5   \S<5>73_f5  (
    .I0(\S<5>73 ),
    .I1(N1),
    .S(\S<5>54_411 ),
    .O(S_5_OBUF_451)
  );
endmodule

/*
`ifndef GLBL
`define GLBL

`timescale  1 ps / 1 ps

module glbl ();

    parameter ROC_WIDTH = 100000;
    parameter TOC_WIDTH = 0;

    wire GSR;
    wire GTS;
    wire GWE;
    wire PRLD;
    tri1 p_up_tmp;
    tri (weak1, strong0) PLL_LOCKG = p_up_tmp;

    reg GSR_int;
    reg GTS_int;
    reg PRLD_int;

//--------   JTAG Globals --------------
    wire JTAG_TDO_GLBL;
    wire JTAG_TCK_GLBL;
    wire JTAG_TDI_GLBL;
    wire JTAG_TMS_GLBL;
    wire JTAG_TRST_GLBL;

    reg JTAG_CAPTURE_GLBL;
    reg JTAG_RESET_GLBL;
    reg JTAG_SHIFT_GLBL;
    reg JTAG_UPDATE_GLBL;
    reg JTAG_RUNTEST_GLBL;

    reg JTAG_SEL1_GLBL = 0;
    reg JTAG_SEL2_GLBL = 0 ;
    reg JTAG_SEL3_GLBL = 0;
    reg JTAG_SEL4_GLBL = 0;

    reg JTAG_USER_TDO1_GLBL = 1'bz;
    reg JTAG_USER_TDO2_GLBL = 1'bz;
    reg JTAG_USER_TDO3_GLBL = 1'bz;
    reg JTAG_USER_TDO4_GLBL = 1'bz;

    assign (weak1, weak0) GSR = GSR_int;
    assign (weak1, weak0) GTS = GTS_int;
    assign (weak1, weak0) PRLD = PRLD_int;

    initial begin
	GSR_int = 1'b1;
	PRLD_int = 1'b1;
	#(ROC_WIDTH)
	GSR_int = 1'b0;
	PRLD_int = 1'b0;
    end

    initial begin
	GTS_int = 1'b1;
	#(TOC_WIDTH)
	GTS_int = 1'b0;
    end

endmodule

`endif
*/
