nachtluce/3710-Project/Final Handin/Project Code/Test Modules/Fibonacci Test/LCD_Fib.v

`timescale 1ns / 1ps
//////////////////////////////////////////////////////////////////////////////////
// Company: 
// Engineer: 
// 
// Create Date:    18:50:59 09/27/2011 
// Design Name: 
// Module Name:    LCD_Fib 
// Project Name: 
// Target Devices: 
// Tool versions: 
// Description: 
//
// Dependencies: 
//
// Revision: 
// Revision 0.01 - File Created
// Additional Comments: 
//
//////////////////////////////////////////////////////////////////////////////////
module LCD_Fib(
    input clk,
    input reset,
    input SF_CEO,//this is for disabling the flash
    output [11:8] SF_D,// lcd control
    output LCD_E,		//lcd control
    output LCD_RS,	//lcd control
    output LCD_RW,	//lcd control
    input [3:0] switches,
    input SetA,
    input SetB
    );
	
	assign SF_CE0=1;	//disable flash (shares some pins with LCD)

	wire [15:0] tempOut;
	wire gnd;
	assign gnd = 0;

	Fibonacci f( clk, ~reset, ~SetA, ~SetB, switches, tempOut);
	
	lcd_ctrl l(clk, gnd, tempOut, SF_D, LCD_E, LCD_RS, LCD_RW);
endmodule
