nachtluce/3710-Project/(commit log)

2011-09-07 i am commiting the opcode instruction set
    [OP_CODE.xlsx]
2011-09-13 Added AND to the ALU. When simulating I do have have any errors printed. Seems a bit funny to me because most of the ALU is not functioning at this time. Seems that all of the errors printed before c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
    [ALUmod.v, alu_TestBench2.v]
2011-09-13 I am commiting the alu it is working, but my not be the fully operating correct version
    [alu_TestBench2.v]
2011-09-13 I added some labeling to the error output
    [alu_TestBench2.v]
2011-09-15 Fixed warnings in ALU that states latches were being created
    [ALUmod.v]
2011-09-15 Removed ALU check for zero ability to conform to tests. Changed some tests that were checking for the wrong flags.
    [ALUmod.v, alu_TestBench2.v]
2011-09-17 Changed the tesbench which was reporting that there was an error with the mov command, but it was really testing the logical shift. NOT in the ALU is now a logical not, rather than a bit by bit NOT. 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
    [ALUmod.v, alu_TestBench2.v]
2011-09-17 Fixed some problems in the ALU design and the test code for ADDC. Some tests had to clear the carry flag. The ALU code has changed as well so it was recording the F flag correctly.
    [ALUmod.v, alu_TestBench2.v]
2011-09-21 Fixed regfile2.v to actually work. (maybe)
    [RegFile2.v, RegisterFileTest2.v]
2011-09-28 fixed compile errors in fibonacci.v
    [Fibonacci.v]
2011-09-29 I am just trying to receive the values online, sorry for the errors
    [Fibonacci.v]
2011-09-29 changed to no reset.
    [Fibonacci.v, LCD_Fib.v]
2011-10-01 Changes to not use buttons on board.
2011-10-19 Added the CPU design file to documentation.
    [CPU Design.xls]
2011-10-20 Added changes to instruction set.
    [OP_CODE.xlsx]
2011-10-20 I have added the background to the power point presentation.
2011-10-24 Modified OP_Code.xlsx to correct some mistakes and make some simplifying changes
    [OP_CODE.xlsx]
2011-10-25 Made changes to the ALU to bring it up to the current design
2011-10-27 added some missing files to the VGA memory
    [VGA_memory.v]
2011-10-30 Modified CPU Design.xls and added CPU_Controller.v
    [CPU Design.xls]
2011-10-30 reset is set if it is 1
    [program_counter.v]
2011-11-01 Added some test code that verified that two core memories can used at the same time on the same board. The program works by having a button select what is being displayed (what memory is being pulled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
2011-11-02 Work on CPU design
    [OP_CODE.xlsx]
2011-11-03 Added mif file for blk mem
    [CPU Design.xls, OP_CODE.xlsx]
2011-11-03 Added start of assembler
2011-11-04 Did a bunch of work on a computer without the git repo. The assembler is now in a form that works under some conditions.
2011-11-05 assembler now can encode some instructions correctly. using labels in the assembly code does not yet work.
2011-11-05 added a readme that talks about the assembler, next I need to make the coe program
2011-11-07 Fixed a bug where the PC would reset to 0 if it was not incrementing.
    [program_counter.v]
2011-11-07 missing delaration of Memwrite in file
    [CPU_with_Memory_Test.v]
2011-11-08 Moved the code around to prevent errors and warnings when trying to synthisize. This was because an additional always block would try to write to values being written to in the other always block
    [CPU.v, CPU_Controller.v]
2011-11-08 Changed the what program is loaded into memory for testing purposes. Added the asm file of the program loaded. Found an inconsistancy in the documentation of opcodes, the assembler uses what is in th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
2011-11-08 this is all the VGA controlling stuff, and some documentation
    [characterLayout.xls]
2011-11-08 modified opcode.xlsx for conditional instructions and fix mistake.
    [OP_CODE.xlsx]
2011-11-08 modified the opcodes file again
    [OP_CODE.xlsx]
2011-11-09 modified core gen. Working on assembler, it does not work at this time.
    [blk_mem_gen_v6_1.v]
2011-11-09 refactored some code in assembler
2011-11-09 Finished adding support for branch and jump to assembler. I have not yet tested it.
2011-11-09 Fixed (hopefully) load/store logic in controller
    [CPU_Controller.v]
2011-11-09 Set the memory out to be from the ALU and not hard wired to zero.
2011-11-10 added branching instructions modified opcode mnemonics
    [OP_CODE.xlsx]
2011-11-10 added CMP to assembler
2011-11-10 Added Jump, StorePC, JCond, instructions and changed pc to increment as signed values
    [OP_CODE.xlsx]
2011-11-11 fixed what was gonig to the bux mux
    [CPU.v]
2011-11-14 Fixed PSR so it stays latched until the next execute phase, and fixed the CMP instruction in the ALU to set the flags properly.
    [ALUmod.v, CPU.v, CPU_Controller.v, Processor_Status_Register.v, blk_mem_gen_v6_1.v]
2011-11-14 Fixed the ALU and CPU Controller to use CLFZN instead of CZLFN...
    [CPU Design.xls, OP_CODE.xlsx]
2011-11-16 added some more debug support for the assembler
2011-11-16 Found a bug in the sign extend for the immediate value for CMPI instructions. This has been fixed, it now extends the sign according to the MSB of the immediate value being passed in, rather than alw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
    [CPU_Controller.v]
2011-11-17 Changed the operation of conditional jumps to increment PC by offset when true.
    [CPU Design.xls, OP_CODE.xlsx]
2011-11-17 Added final (hopefully) instructions to opcode.xlsx
    [OP_CODE.xlsx]
2011-11-18 added support for instructions to interface with devices.
2011-11-18 sum recursive program runs as expected on the current CPU
2011-11-19 Fixed a bug in the vga controller that cause images to be dim sometimes.
    [VGA_TOP_CNTRL.v, vgaBitGen.v, vgaMemoryAccess.v]
2011-11-19 Implemented gamepad and VGA instruction
    [CPU Design.xls]
2011-11-20 MOVIU instruction in the ALU did not set CLFZN, causing problems with synthesizing. This has been corrected.
    [ALUmod.v]
2011-11-20 serialData should be 16 bits, this has been fixed.
    [CPU.v]
2011-11-21 Added a seperate clock that runs at 25 Mhz because the CPU has too many levels of logic to run at 50, but othre modules run at 50Mhz clock. Also, currently reset is tied to 0, so I had to invert all 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
    [CPU_with_Memory_Test.v]
2011-11-21 A feature was implemented that supported just puting the number of the register to use without the R prefix. I found this caused too many bugs that were difficult to find. Now a register is required 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
2011-11-22 I have updated the levels to have the correct format for a copy and paste into the assembler
2011-11-22 Added system clock to cpu, and CLOCK instruction to read it.
    [OP_CODE.xlsx]
2011-11-24 Added lights to the UCF file so I know if I am really pressing buttons on the controller, I can not get the guy to run around the screen.
    [characterLayout.xls]
2011-11-24 Added clock command to the assembler.
2011-11-26 the game now supports the character walking around the map. no support for automatic camera movement yet.
2011-11-26 fixed a bug that the assembler was loading information high bits to low. The CPU does not support this, so data is loaded low bits to high for loading compleate words into memory.
2011-11-29 added a warning message if explicent constants are used in assembly. There are few reasons to not use labels, so a warning was added because it helps me find common errors in my code.
2011-11-30 fixed vga problem with memory access making the pictures look funny.
    [vgaBitGen.v]
2011-11-30 when the game is won, pressing the start button will reset the game.
2011-12-03 Mades some changes so module synthesized correctly with serial controller.
    [CPU.v, CPU_Controller.v, CPU_with_Memory_Test.v, SerialController.v, SerialReceive.v, SerialTransmit.v]
2011-12-06 Fixed issue with serial instruction
    [CPU_Controller.v, blk_mem_gen_v6_1.v]
2011-12-07 Fixed CPU controller so READSERIAL only writes to a register when there is good data to be had.
    [CPU_Controller.v]
2011-12-08 Added new program with frames
2011-12-17 Added the final handin directory with all files organized for the final handin, still needs to have the final bit file anad report added.
    [CPU Design.xls, OP_CODE.xlsx, characterLayout.xls]
2011-12-18 added sections about assembler and software
